gusdistefano/baby_cpr/chaleco/interior.jpeg

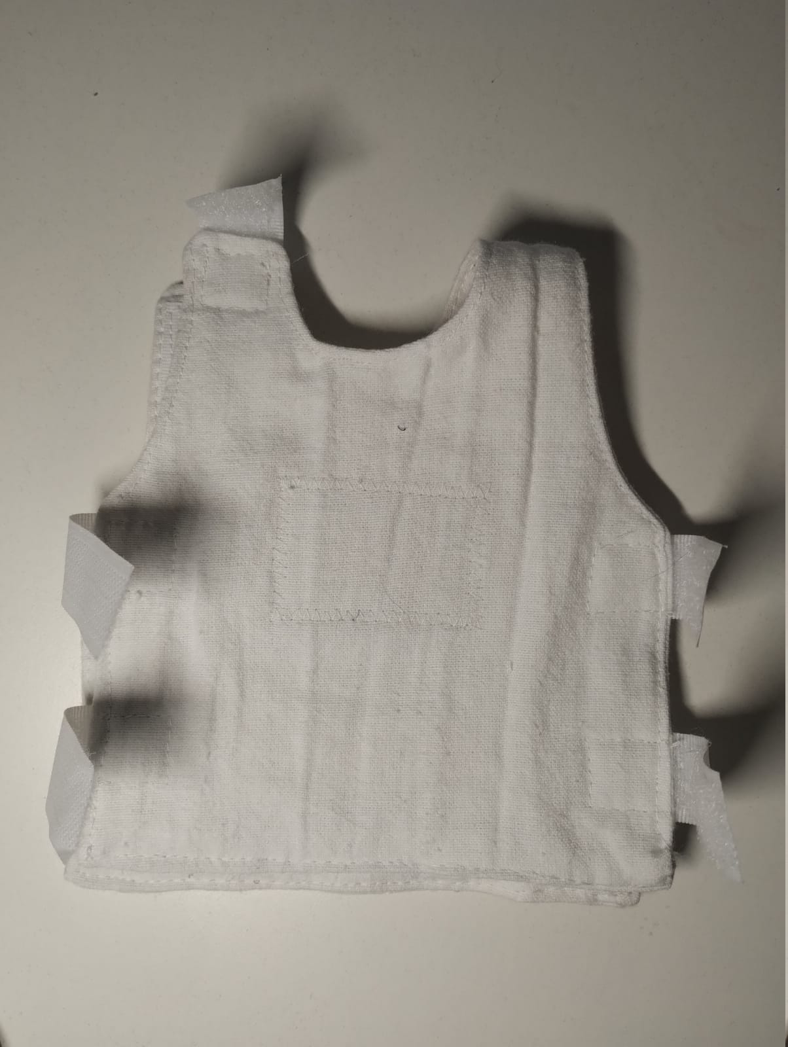
chaleco/interior.jpeg
