gusdistefano/baby_cpr/chaleco/dorso.jpeg

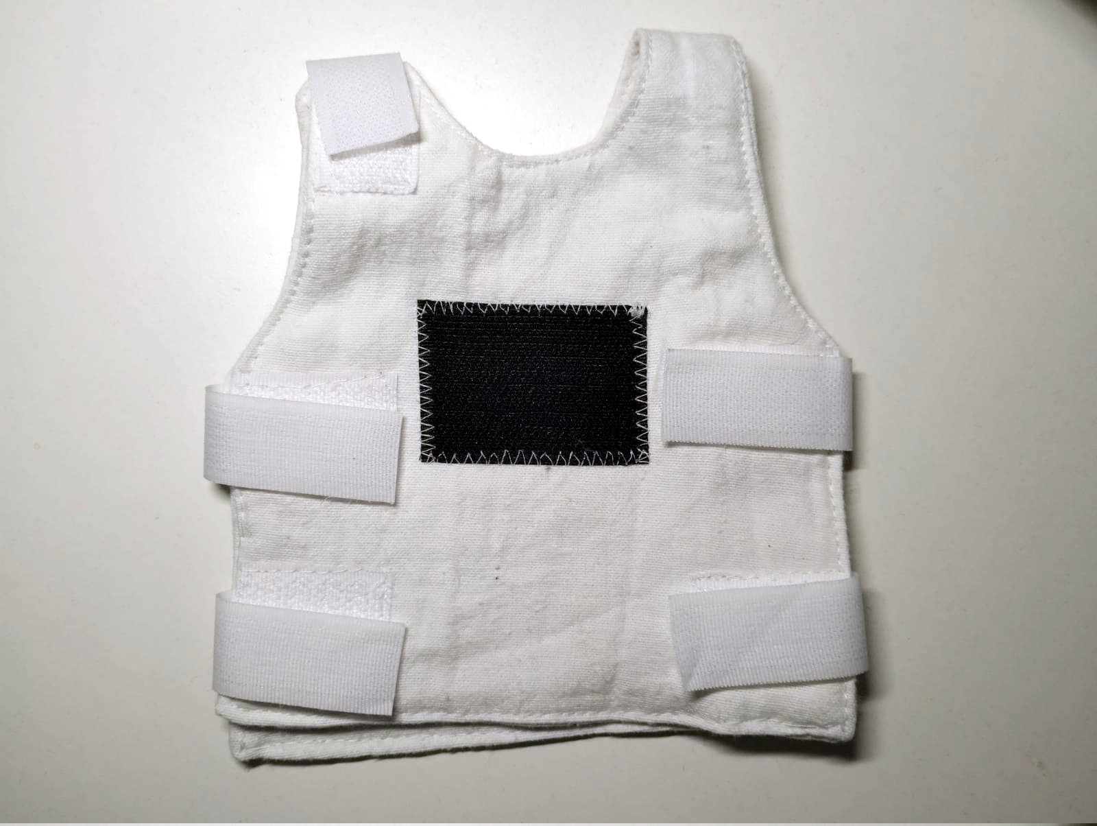
chaleco/dorso.jpeg
