gusdistefano/baby_cpr/README.md

# Neonatal CPR Simulator

This repository is available in multiple languages:

- [English](README_EN.md)

- [Español](README_ES.md)
