gusdistefano/baby_cpr/chaleco/Medidas maniqui.md

# Medidas maniqui

Largo total: 40 cm

Largo torax y abdomen:  14 cm  (22 cuad ) -.68

Ancho torax: 9 cm  (18 cuad) ---> 11 cm .61

Diametro de torax: 28 cm

Cuello esternon: 3 cm

Cuello hasta donde termina el pecho: 5 cm

Altura torax (pecho-espalda): 8 cm
