gusdistefano/baby_cpr/chaleco/chaleco.png

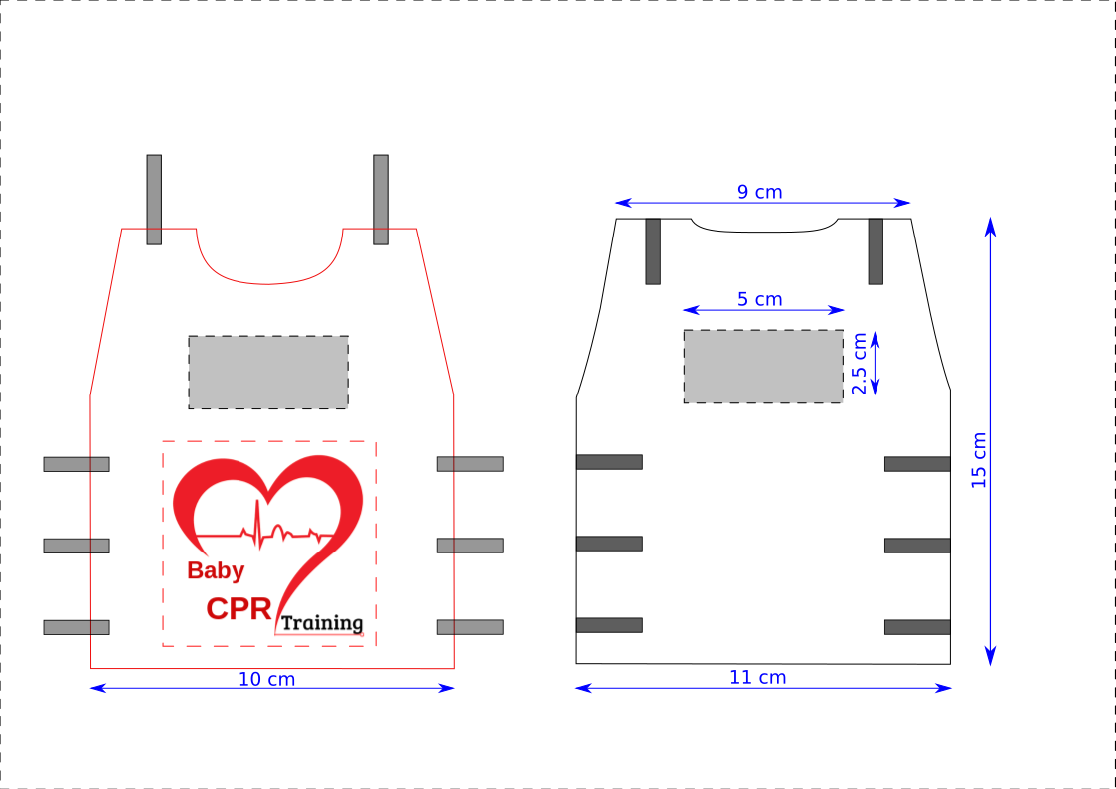
chaleco/chaleco.png
