gusdistefano/baby_cpr/chaleco/cpr1-tranps.png

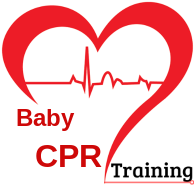
chaleco/cpr1-tranps.png
