gusdistefano/baby_cpr/chaleco/frente.jpeg

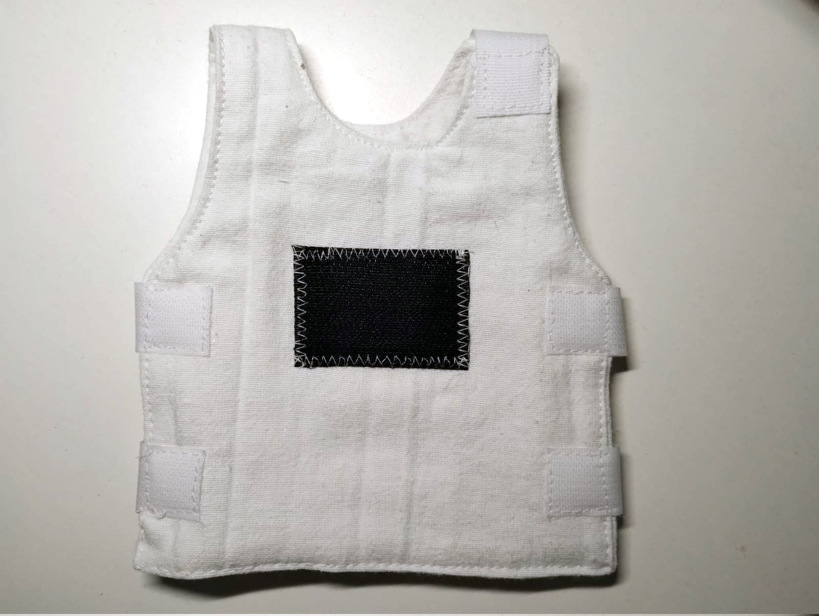
chaleco/frente.jpeg
