gusdistefano/baby_cpr/docs/doxygen/dir_619a81ad29a4b41c30712238698673ac_dep.png

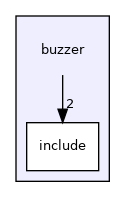
docs/doxygen/dir_619a81ad29a4b41c30712238698673ac_dep.png
