gusdistefano/baby_cpr/docs/doxygen/dir_737120a9b1b8e21c34d02256dfc20c78_dep.png

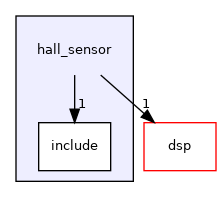
docs/doxygen/dir_737120a9b1b8e21c34d02256dfc20c78_dep.png
