gusdistefano/baby_cpr/docs/doxygen/dir_7539740a674fe554df3e16c8629ce56f_dep.png

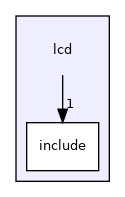
docs/doxygen/dir_7539740a674fe554df3e16c8629ce56f_dep.png
