gusdistefano/baby_cpr/(threads)

Thread 1 (2025-02-03):

Video simulacion de pantallas en SquareLine Studio

gusdistefano, 2025-02-03:
El siguiente video fue generado con el simulador de **SquareLine Studio** para ver como se comportan todas las pantallas del sistema.
Se pueden apreciar las pantallas de

- **Pantalla SplashScreen**: Presentación con el logo de la aplicación "CPR Training", referencia al desarrollador y el logo de la UNER
- **Pantalla MenuPrincipal**: Menú con opciones principales: "Modo Entrenamiento", "Modo Evaluación" y "Configuración".
- **Pantalla Modo Entrenamiento**: Indicadores de profundidad y frecuencia de compresiones, con estadísticas de corrección y botones de control. Se aprecia el botton toggle del metronomo, para guia de practica.
- **Pantalla Modo Evaluación**: Parámetros de evaluación (tiempo y tasa de compresiones), tiempo restante y opciones de configuración y control.
- **Pantalla Resultados** : Muestra los parámetros de evaluación (tiempo y tasa de compresiones) y los resultados obtenidos, incluyendo tiempo real de ejecución, tasa promedio y porcentaje de compresiones correctas, superficiales y profundas. Botón para volver al menú anterior.

https://github.com/user-attachments/assets/c030813a-a93e-4d8c-a8e2-dbf3dda8c5f7

Thread 2 (2025-02-03):

Manual de Usuario del Baby CPR Training

gusdistefano, 2025-02-03:
Link de descarga

[Manual de Usuario del Baby CPR Training.pdf](https://github.com/user-attachments/files/18647980/Manual.de.Usuario.del.Baby.CPR.Training.pdf)

Thread 5 (2025-02-26):

Video presentación del proyecto

gusdistefano, 2025-02-26:
El siguiente video es la presentación del Proyecto Final de la Especialización en Sistemas Embebidos

**Simulador para RCP Neonatal**

[[Vimeo](https://vimeo.com/manage/videos/1060556957)](https://vimeo.com/manage/videos/1060556957)

[[YouTube](https://youtu.be/-3k3PjLmu0U)](https://youtu.be/-3k3PjLmu0U)
