gusdistefano/baby_cpr/PCB/rcp_neo_v2.2/rcp_neo_v2.2.kicad_pcb

## KiCad design PCB/rcp_neo_v2.2/rcp_neo_v2.2.kicad_pcb (2025-02-04)

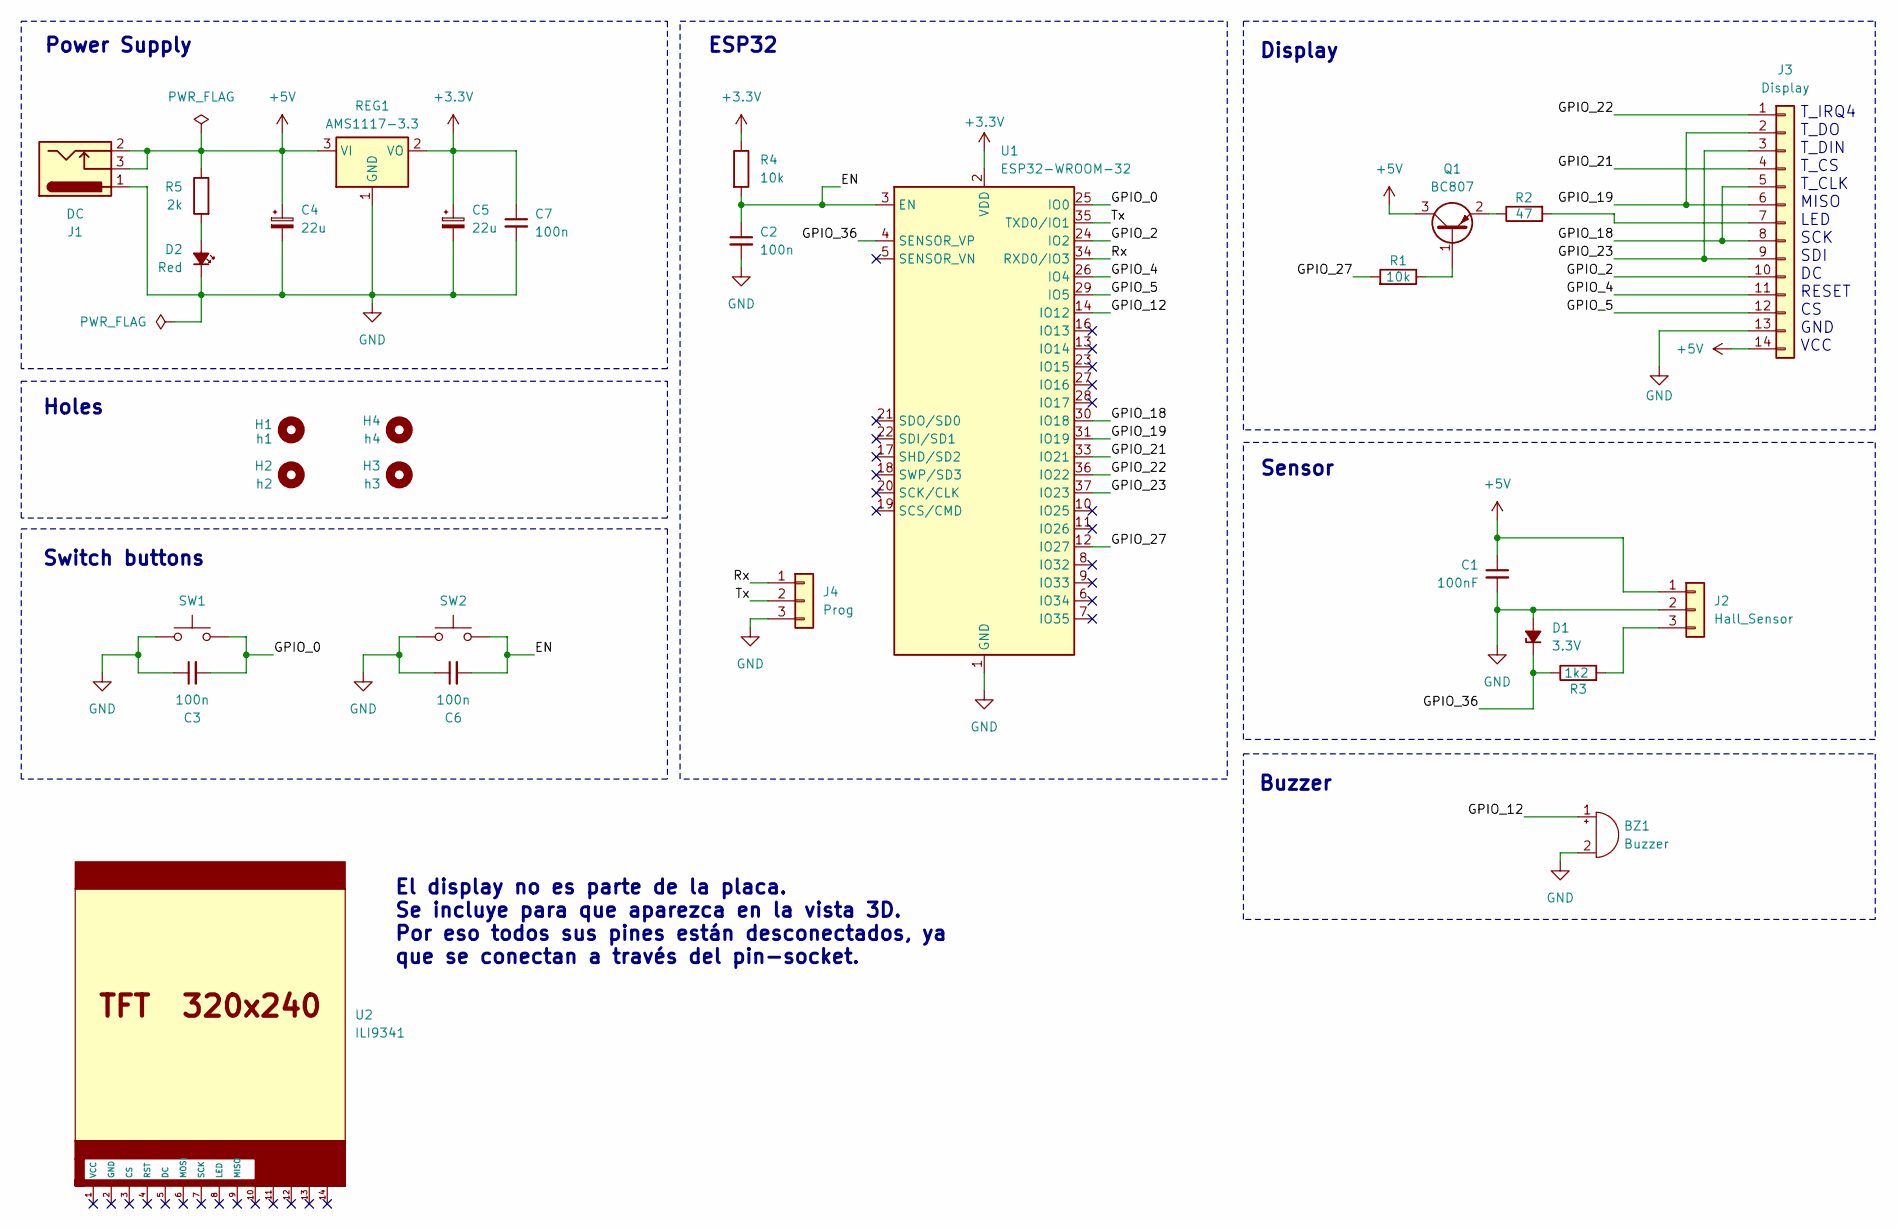
[picture p15: schematic rcp_neo_v2.2.kicad_sch, RCP Neonatal]

Parts:
BZ1: Buzzer; Buzzer_12x9.5RM7.6
C1: 100nF; C_1206_3216Metric_Pad1.33x1.80mm_HandSolder
C2, C3, C6, C7: 100n; C_1206_3216Metric_Pad1.33x1.80mm_HandSolder
C4, C5: 22u; CP_Elec_5x4.4
D1: 3.3V; D_DO-35_SOD27_P7.62mm_Horizontal
D2: Red; LED_D3.0mm_Horizontal_O1.27mm_Z2.0mm
H1: h1; MountingHole_3mm
H2: h2; MountingHole_3mm
H3: h3; MountingHole_3mm
H4: h4; MountingHole_3mm
J1: DC; BarrelJack_Horizontal
J2: Hall_Sensor; PinHeader_1x03_P2.54mm_Horizontal
J3: Display; PinSocket_1x14_P2.54mm_Vertical
J4: Prog; PinHeader_1x03_P2.54mm_Horizontal
Q1: BC807; SOT-23
R1, R4: 10k; R_1206_3216Metric_Pad1.30x1.75mm_HandSolder
R2: 47; R_1206_3216Metric_Pad1.30x1.75mm_HandSolder
R3: 1k2; R_1206_3216Metric_Pad1.30x1.75mm_HandSolder
R5: 2k; R_1206_3216Metric_Pad1.30x1.75mm_HandSolder
REG1: AMS1117-3.3; SOT-223-3_TabPin2
SW1, SW2: SW_Push; SW_SPST_B3U-1000P
U1: ESP32-WROOM-32
U2: ILI9341; TFT-320x240_ILI9341_TOUCH

Connections:
+3.3V: C5.1, C7.1, R4.1, REG1.2 (VO), U1.2 (VDD)
+5V: C1.1, C4.1, J1.2, J1.3, J2.1, J3.14, Q1.3 (C), R5.1, REG1.3 (VI)
/EN: C2.1, C6.2, R4.2, SW2.2, U1.3 (EN)
/GPIO_0: C3.2, SW1.2, U1.25 (IO0)
/GPIO_2: J3.10, U1.24 (IO2)
/GPIO_4: J3.11, U1.26 (IO4)
/GPIO_5: J3.12, U1.29 (IO5)
/GPIO_12: BZ1.1 (+), U1.14 (IO12)
/GPIO_18: J3.5, J3.8, U1.30 (IO18)
/GPIO_19: J3.2, J3.6, U1.31 (IO19)
/GPIO_21: J3.4, U1.33 (IO21)
/GPIO_22: J3.1, U1.36 (IO22)
/GPIO_23: J3.3, J3.9, U1.37 (IO23)
/GPIO_27: R1.2, U1.12 (IO27)
/GPIO_36: D1.1 (K), R3.1, U1.4 (SENSOR_VP)
/Rx: J4.1, U1.34 (RXD0/IO3)
/Tx: J4.2, U1.35 (TXD0/IO1)
GND: BZ1.2 (-), C1.2, C2.2, C3.1, C4.2, C5.2, C6.1, C7.2, D1.2 (A), D2.1 (K), J1.1, J2.2, J3.13, J4.3, REG1.1 (GND), SW1.1, SW2.1, U1.1 (GND), U1.15 (GND), U1.38 (GND), U1.39 (GND)
unnamed: D2.2 (A), R5.2
unnamed: J2.3, R3.2
unnamed: J3.7, R2.2
unnamed: Q1.1 (B), R1.1
unnamed: Q1.2 (E), R2.1

Notes on the sheet:
ESP32
El display no es parte de la placa. Se incluye para que aparezca en la vista 3D. Por eso todos sus pines están desconectados, ya que se conectan a través del pin-socket.
Buzzer
Switch buttons
Sensor
Display
T_IRQ4 T_DO T_DIN T_CS T_CLK MISO LED SCK SDI DC RESET CS GND VCC
Holes
Power Supply

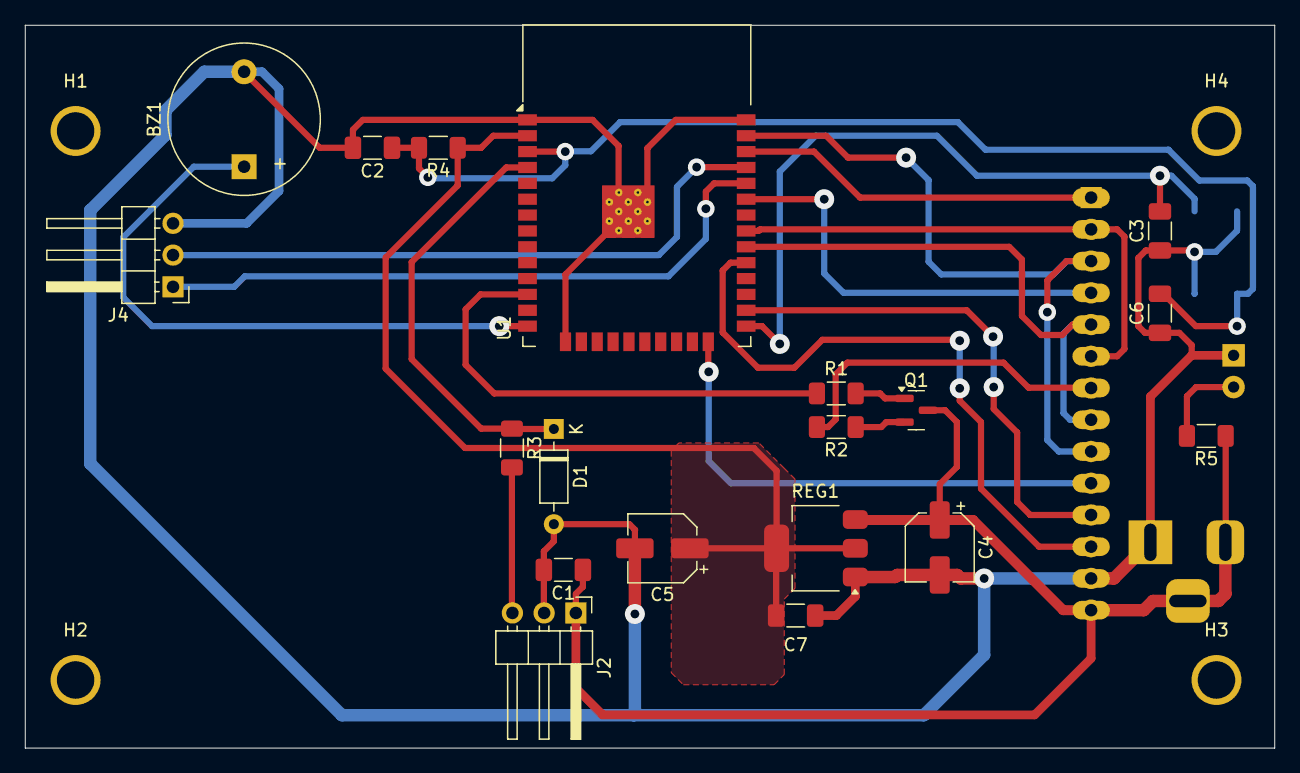
[picture p16: board rcp_neo_v2.2.kicad_pcb from above]

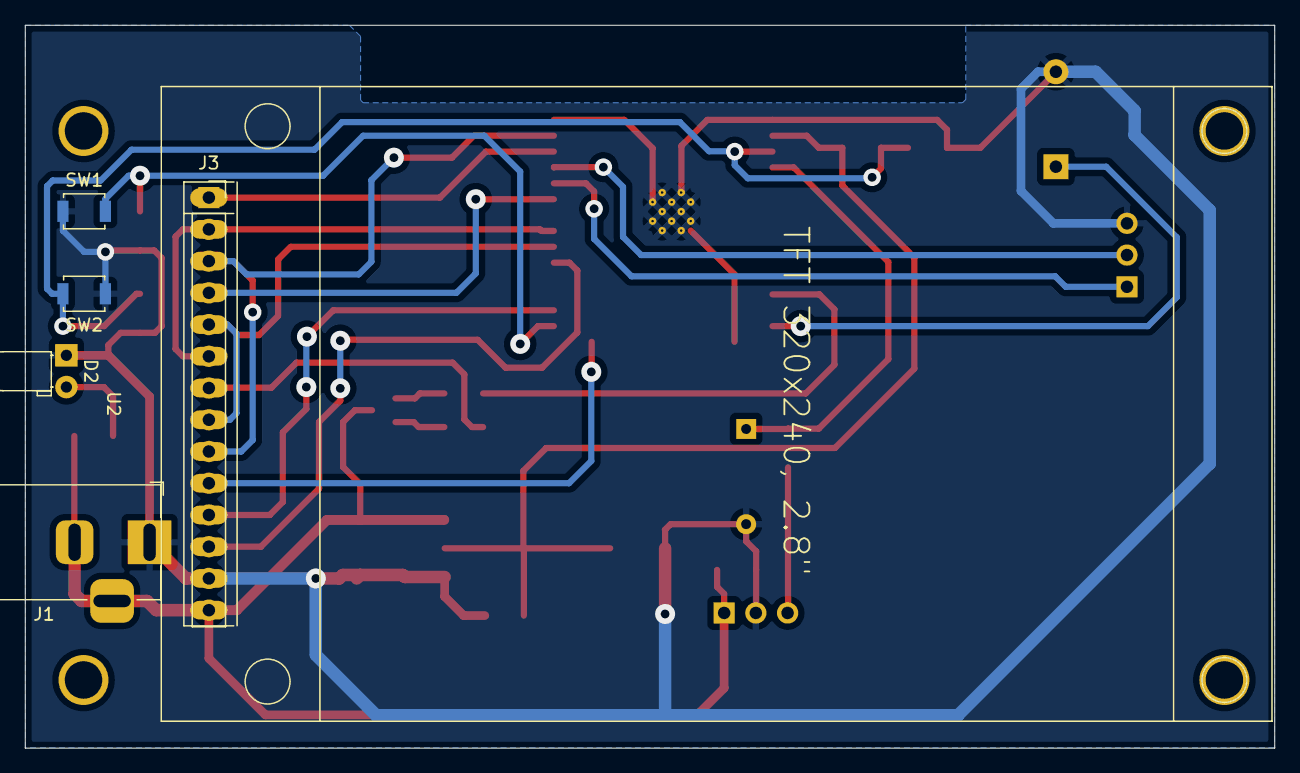
[picture p17: board rcp_neo_v2.2.kicad_pcb from below]

Board: 2 copper layers, 100.0 x 57.9 mm, 29 parts (6 on the bottom side), 23 nets.
