gusdistefano/baby_cpr/PCB/rcp_neo_v1.0/rcp_neo_v1.0.kicad_pcb

## KiCad design PCB/rcp_neo_v1.0/rcp_neo_v1.0.kicad_pcb (2025-02-04, an earlier design)

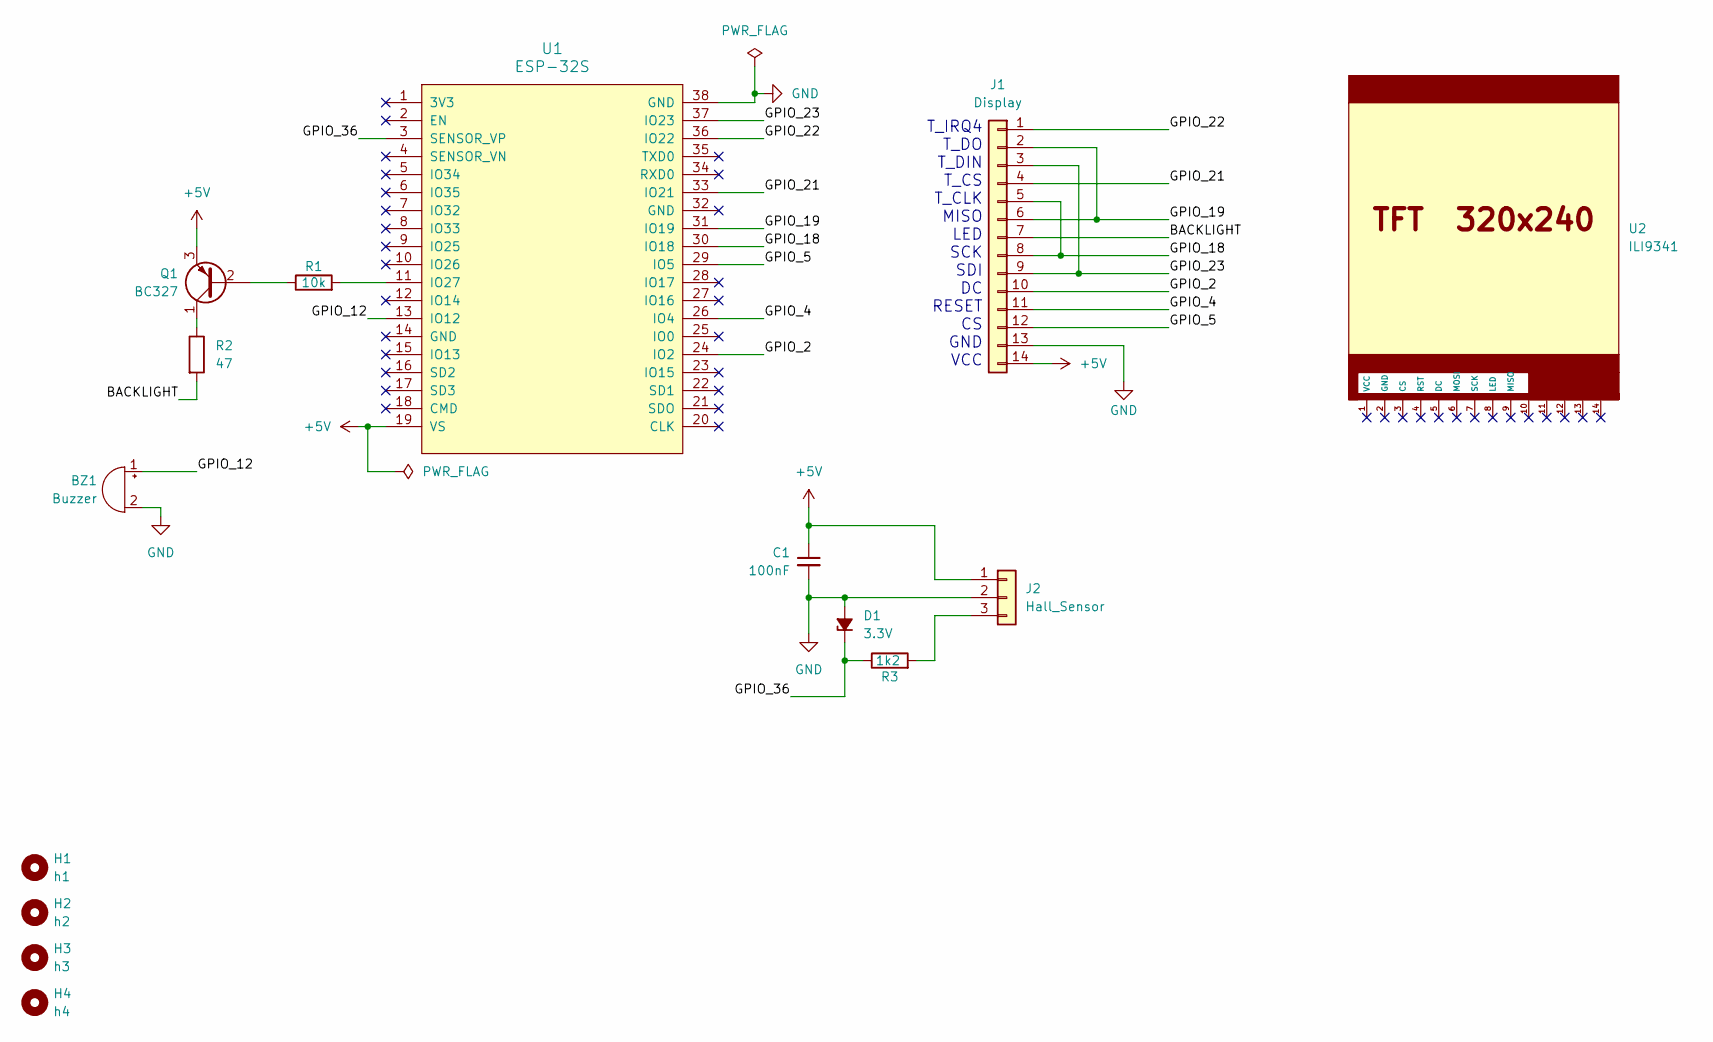
[picture p18: schematic rcp_neo_v1.0.kicad_sch, Simulador RCP - Shield NodeMCU Esp32]

Parts:
BZ1: Buzzer; Buzzer_12x9.5RM7.6
C1: 100nF; C_Disc_D5.0mm_W2.5mm_P5.00mm
D1: 3.3V; D_DO-35_SOD27_P7.62mm_Horizontal
H1: h1; MountingHole_3mm
H2: h2; MountingHole_3mm
H3: h3; MountingHole_3mm
H4: h4; MountingHole_3mm
J1: Display; PinSocket_1x14_P2.54mm_Vertical_SMD_Pin1Left
J2: Hall_Sensor; PinHeader_1x03_P2.54mm_Vertical
Q1: BC327; TO-92_Inline_Wide
R1: 10k; R_Axial_DIN0207_L6.3mm_D2.5mm_P7.62mm_Horizontal
R2: 47; R_Axial_DIN0207_L6.3mm_D2.5mm_P7.62mm_Horizontal
R3: 1k2; R_Axial_DIN0207_L6.3mm_D2.5mm_P7.62mm_Horizontal
U1: ESP-32S; Esp32-S_Wroom32Module_38pins
U2: ILI9341; TFT-320x240_ILI9341_TOUCH

Connections:
+5V: C1.1, J1.14, J2.1, Q1.3 (E), U1.19 (VS)
/BACKLIGHT: J1.7, R2.2
/GPIO_2: J1.10, U1.24 (IO2)
/GPIO_4: J1.11, U1.26 (IO4)
/GPIO_5: J1.12, U1.29 (IO5)
/GPIO_12: BZ1.1 (+), U1.13 (IO12)
/GPIO_18: J1.5, J1.8, U1.30 (IO18)
/GPIO_19: J1.2, J1.6, U1.31 (IO19)
/GPIO_21: J1.4, U1.33 (IO21)
/GPIO_22: J1.1, U1.36 (IO22)
/GPIO_23: J1.3, J1.9, U1.37 (IO23)
/GPIO_36: D1.1 (K), R3.1, U1.3 (SENSOR_VP)
GND: BZ1.2 (-), C1.2, D1.2 (A), J1.13, J2.2, U1.38 (GND)
unnamed: J2.3, R3.2
unnamed: Q1.2 (B), R1.1
unnamed: Q1.1 (C), R2.1
unnamed: R1.2, U1.11 (IO27)

Notes on the sheet:
T_IRQ4 T_DO T_DIN T_CS T_CLK MISO LED SCK SDI DC RESET CS GND VCC

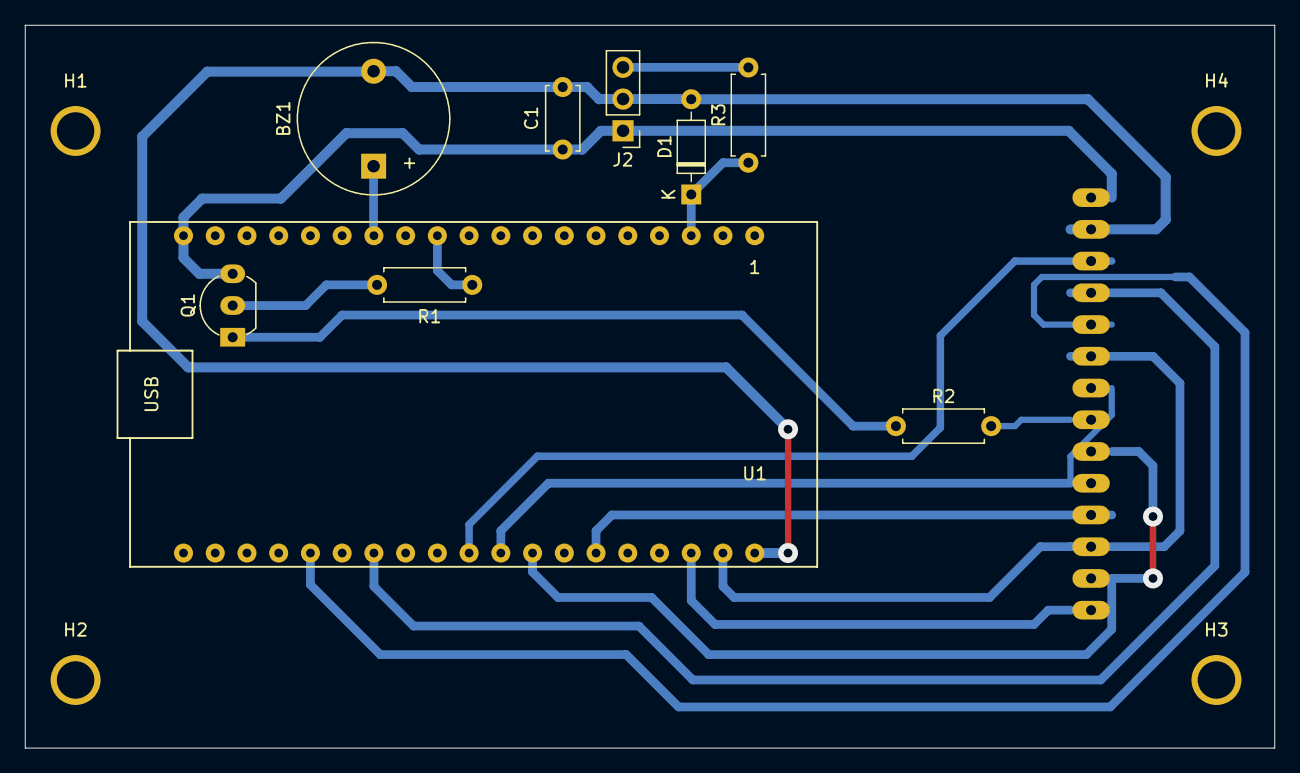
[picture p19: board rcp_neo_v1.0.kicad_pcb from above]

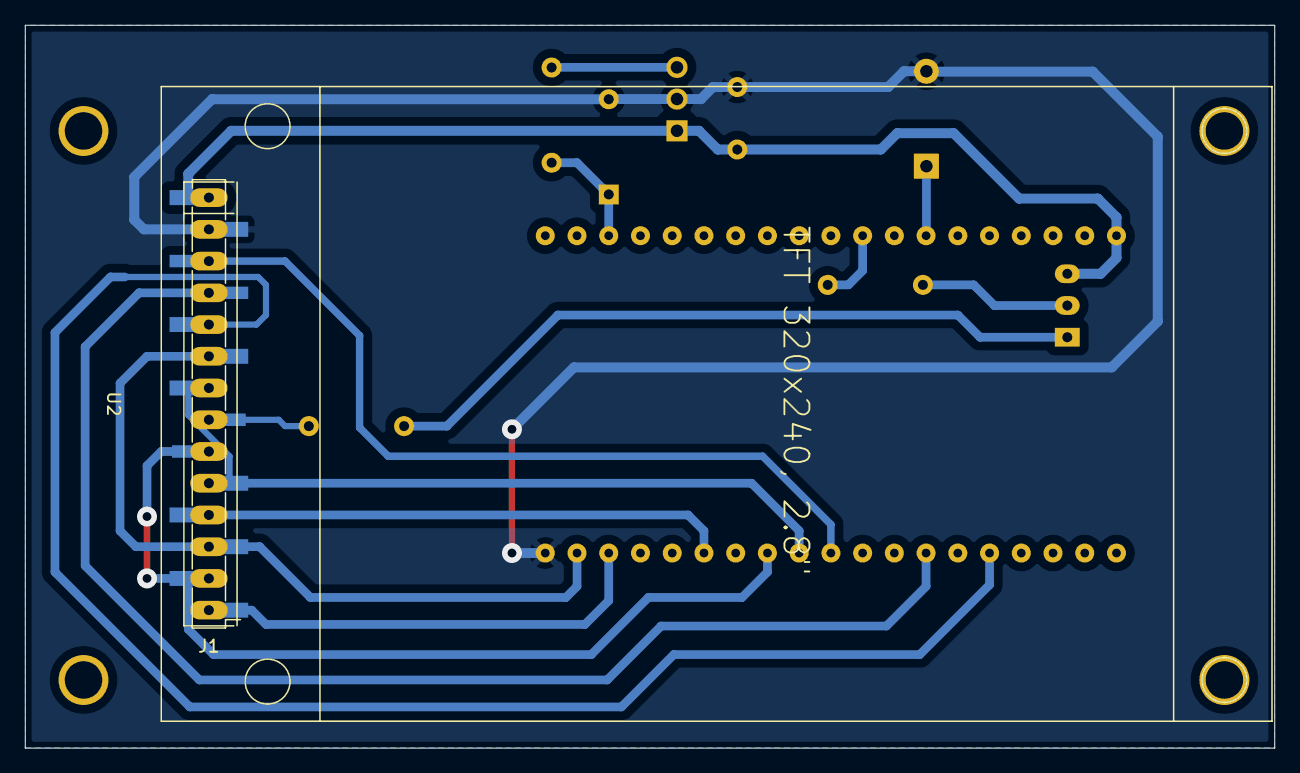
[picture p20: board rcp_neo_v1.0.kicad_pcb from below]

Board: 2 copper layers, 100.0 x 57.9 mm, 15 parts (2 on the bottom side), 17 nets.
