gusdistefano/baby_cpr/components/buzzer/melodys.c

#include "notes.h"
#include "buzzer.h"
#include "freertos/FreeRTOS.h"
#include "freertos/task.h"

#define VOLUME CONFIG_DEFAULT_VOLUME

// Custom delay_ms function
void delay_ms(uint32_t ms)
{
    vTaskDelay(pdMS_TO_TICKS(ms));
}

// Function to play the Pirates of the Caribbean theme
void play_pirate()
{
    play_music_nv(NOTE_D4, 200); // 293.66 ~ NOTE_D4 Hz
    vTaskDelay(pdMS_TO_TICKS(100));
    play_music_nv(NOTE_D4, 100);
    vTaskDelay(pdMS_TO_TICKS(100));
    play_music_nv(NOTE_D4, 200);
    vTaskDelay(pdMS_TO_TICKS(200));
    play_music_nv(NOTE_D4, 100);
    vTaskDelay(pdMS_TO_TICKS(100));
    play_music_nv(NOTE_D4, 200);
    vTaskDelay(pdMS_TO_TICKS(200));
    play_music_nv(NOTE_D4, 100);
    vTaskDelay(pdMS_TO_TICKS(100));
    play_music_nv(NOTE_D4, 100);
    vTaskDelay(pdMS_TO_TICKS(100));
    play_music_nv(NOTE_D4, 100);
    vTaskDelay(pdMS_TO_TICKS(100));
    play_music_nv(NOTE_D4, 100);
    vTaskDelay(pdMS_TO_TICKS(100));
    play_music_nv(NOTE_D4, 200);
    vTaskDelay(pdMS_TO_TICKS(200));
    play_music_nv(NOTE_D4, 100);
    vTaskDelay(pdMS_TO_TICKS(100));
    play_music_nv(NOTE_D4, 200);
    vTaskDelay(pdMS_TO_TICKS(200));
    play_music_nv(NOTE_D4, 100);
    vTaskDelay(pdMS_TO_TICKS(100));
    play_music_nv(NOTE_D4, 200);
    vTaskDelay(pdMS_TO_TICKS(200));
    play_music_nv(NOTE_D4, 100);
    vTaskDelay(pdMS_TO_TICKS(100));
    play_music_nv(NOTE_D4, 100);
    vTaskDelay(pdMS_TO_TICKS(100));
    play_music_nv(NOTE_D4, 100);
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
    play_music_nv(0, 250);
    play_music_nv(NOTE_F3, 250);
    play_music_nv(NOTE_GS3, 500);
    play_music_nv(NOTE_F3, 375);
    play_music_nv(NOTE_C4, 125);

    play_music_nv(NOTE_A3, 500);
    play_music_nv(NOTE_F3, 375);
    play_music_nv(NOTE_C4, 125);
    play_music_nv(NOTE_A3, 1000);
}
