gusdistefano/baby_cpr/(commit log)

2025-02-04 Final version of Neonatal CPR Simulator app
    [configuration.h, rcp_neo_v1.0.kicad_pcb, rcp_neo_v1.0.kicad_sch, rcp_neo_v2.2.kicad_pcb, rcp_neo_v2.2.kicad_sch]
2025-03-24 Eliminacion de comentarios debugging - componente hall_sensor
